laser-game/back/README.md

# Back
PCB includes battery monitoring, booster and indication.

placement
