laser-game/back/fab/back.pdf

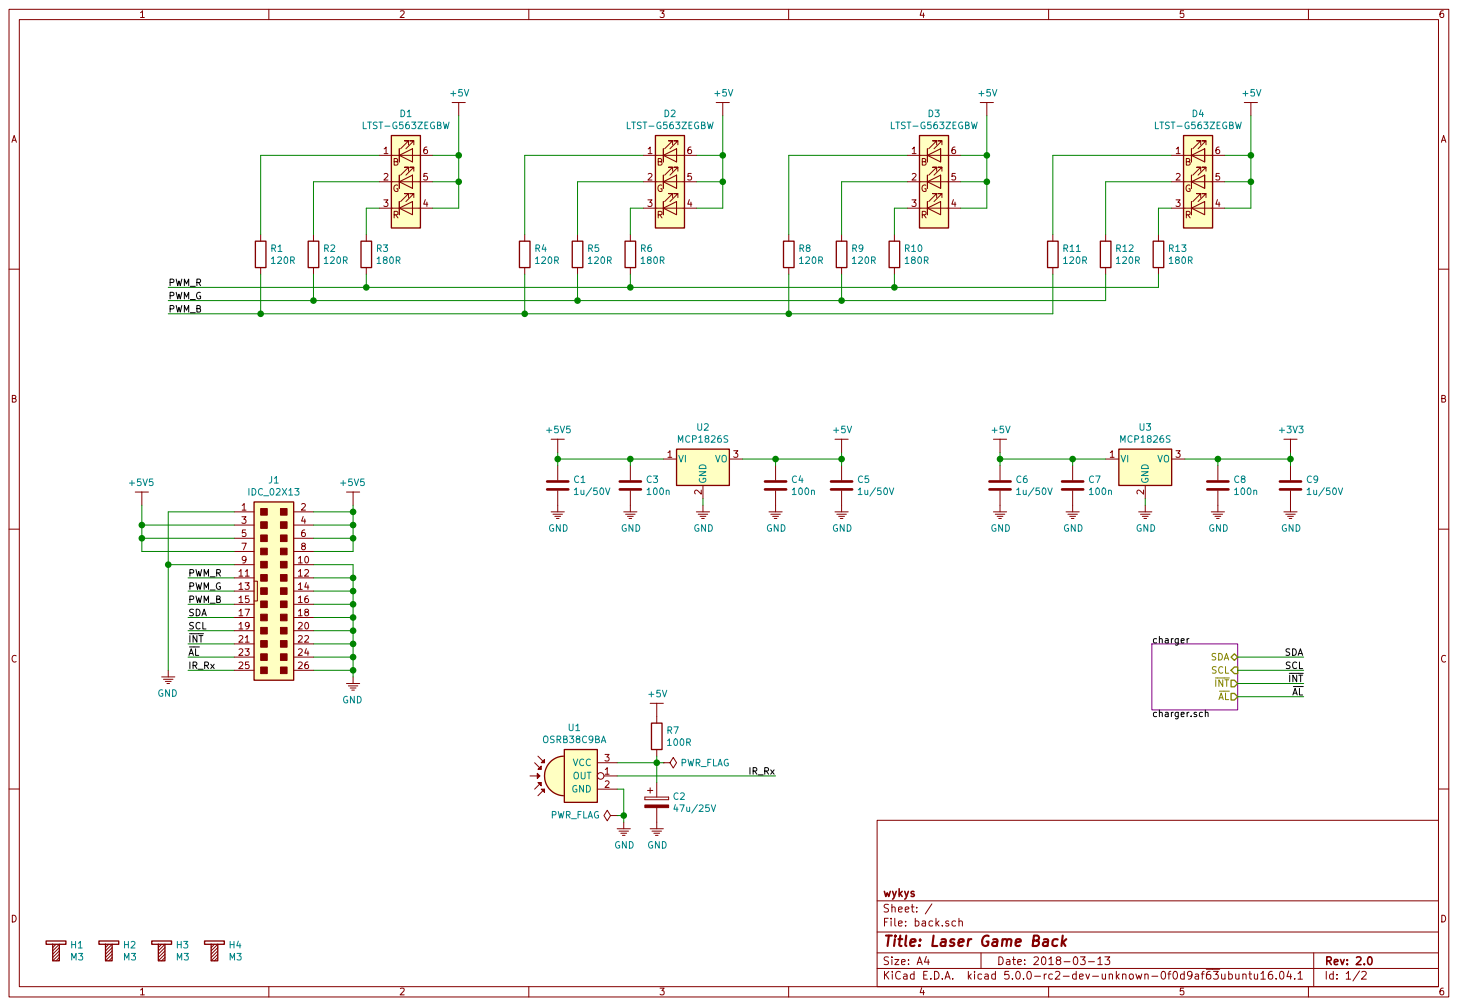
[picture p1: page 1]

File: back.sch Sheet: / wykys

Id: 1/2 Title: Laser Game Back

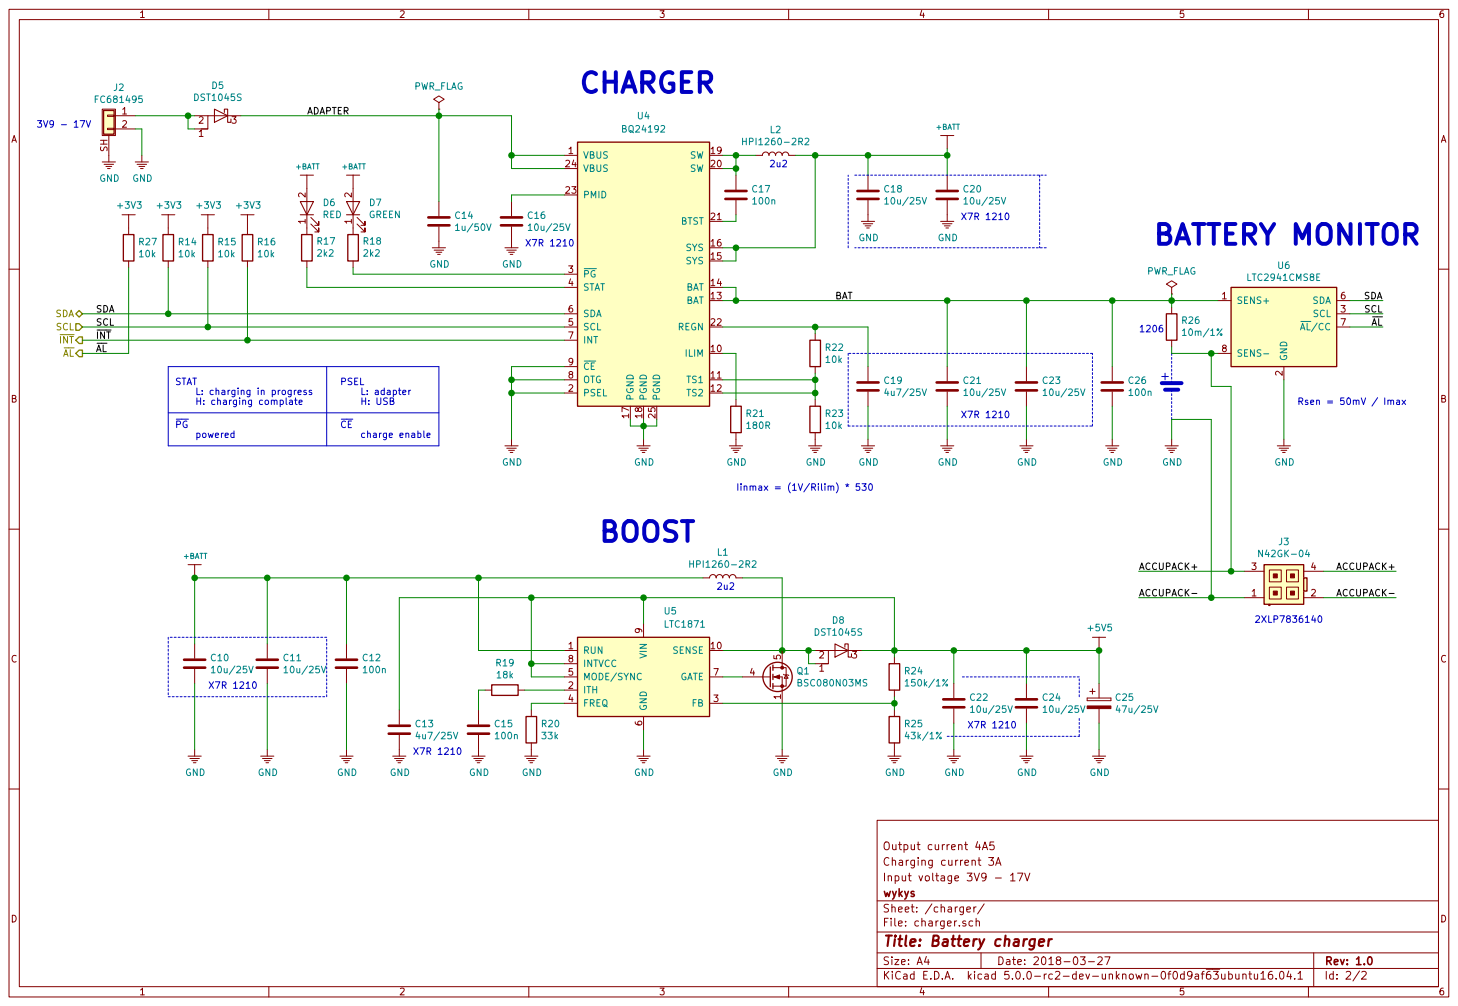
[picture p2: page 2]

2 SCL 3 SDA 6 AL/CC 7 SENS- 8 U6

L: charging in progress H: charging complate PG | charge enable PSEL L: adapter H: USB

Output current 4A5
Charging current 3A
Input voltage 3V9 - 17V
wykys
Sheet: /charger/
File: charger.sch
Id: 2/2 Title: Battery charger
