laser-game/back/sim/boost.asc

C1: cap; 47µ
C2: cap; 22µ
C3: cap; 4.7µ
C4: cap; 100n
C5: cap; 22µ
C6: cap; 100n
D1: schottky; MBRS360
L1: ind; 2.2µ
M1: nmos; BSC080N03MS
R1: res; 150k
R2: res; 43k
R3: res; 33k
R4: res; 18k
R5: res; 18
R6: res; 1.4
S1: sw
U1: LTC1871
V1: voltage; 2.7
V2: voltage; PULSE(-1 1 400u 0 0 200u 400u 1)
V3: voltage; 0
Named nets: 0, OUT, BAT
.tran 0 1m 0 1u startup uic
.model SW SW()
*.step param X 20k 30k 10k
