laser-game/back/hw/back.kicad_pcb

## KiCad design hw/back.kicad_pcb (2018-04-20)

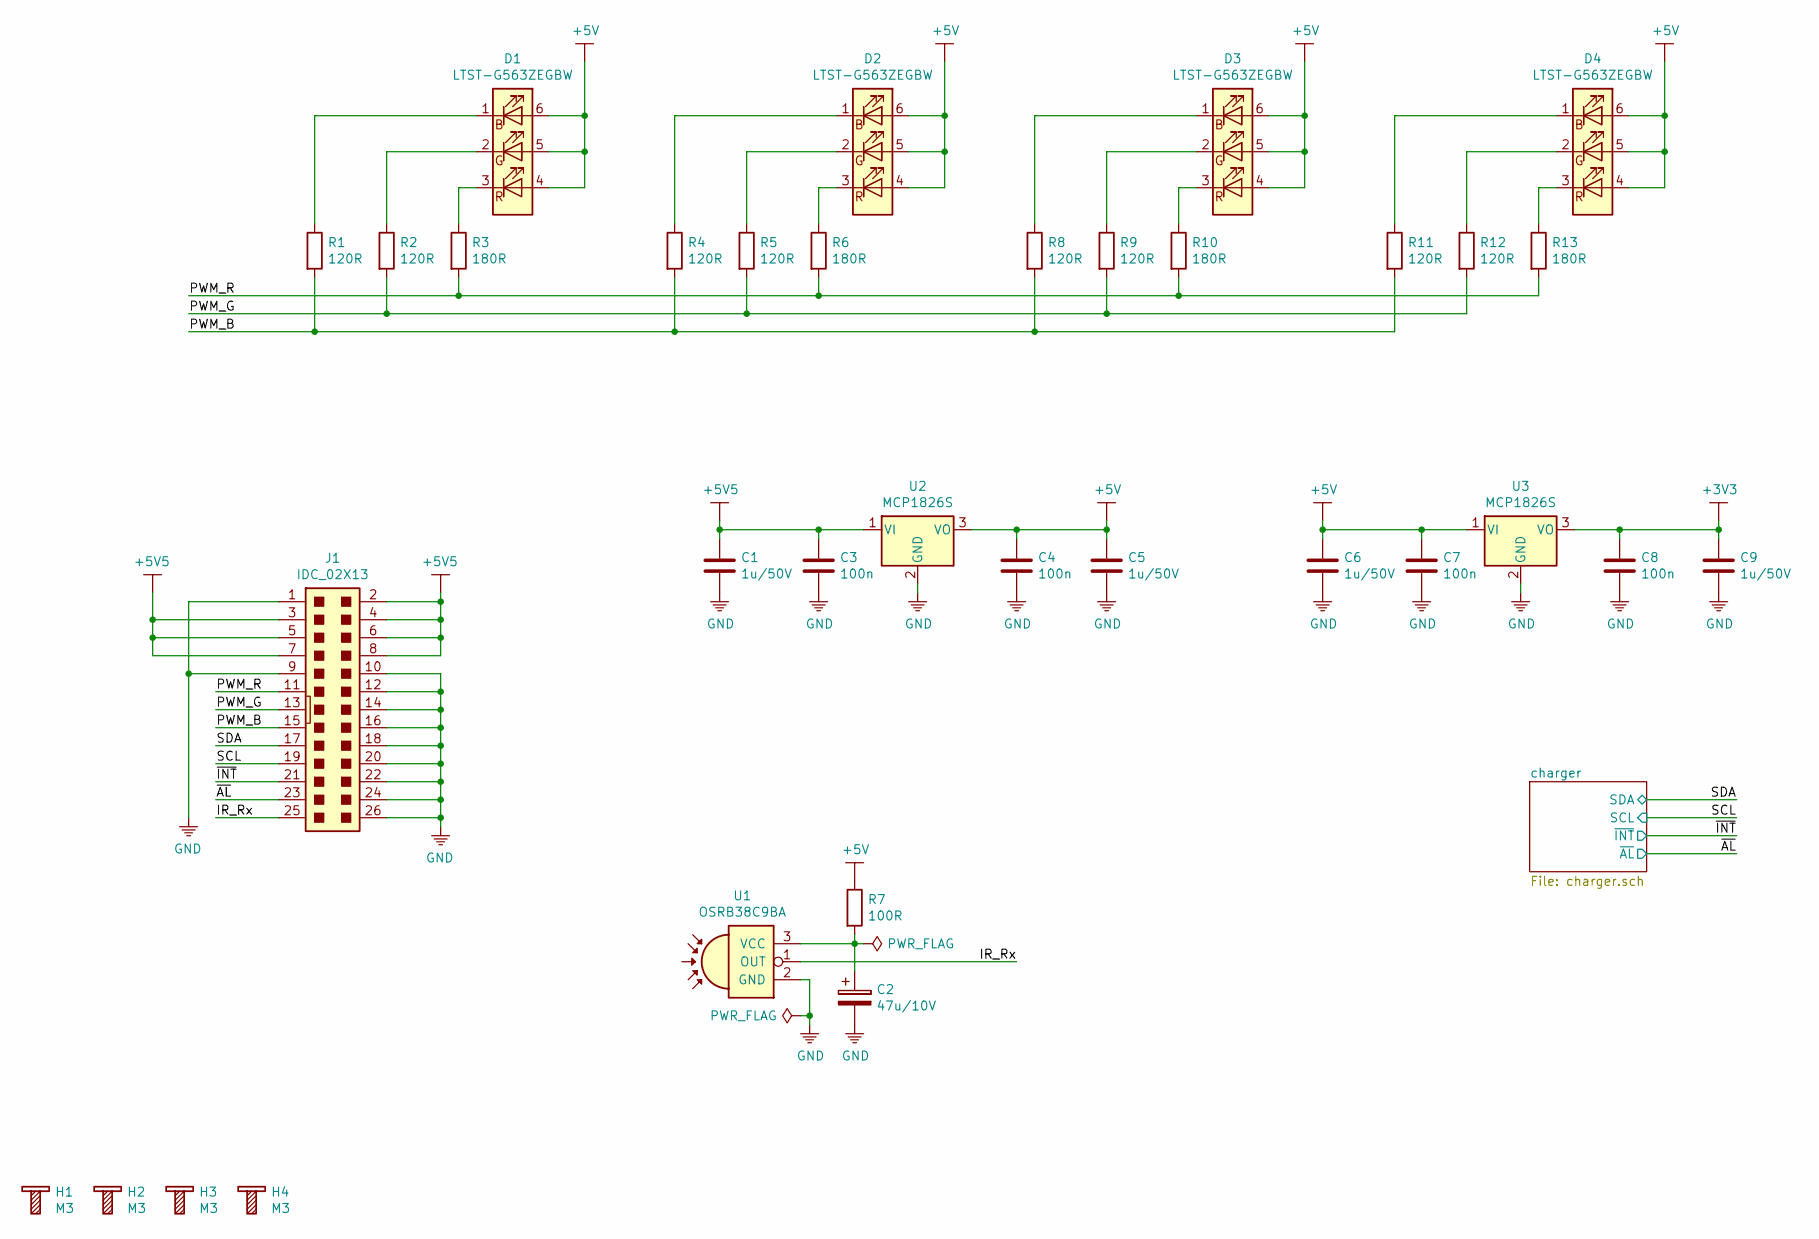
[picture p3: schematic back.sch, Laser Game Back]

Parts:
C1, C5, C6, C9: 1u/50V; C_0805_2012Metric
C2: 47u/10V; CP_EIA-3528-21_Kemet-B
C3, C4, C7, C8: 100n; C_0805_2012Metric
D1, D2, D3, D4: LTST-G563ZEGBW; LED_RGB_5050-6
H1, H2, H3, H4: M3; Bolt_M3
J1: IDC_02X13; IDC-Header_2x13_P2.54mm_Vertical
R1, R2, R4, R5, R8, R9, R11, R12: 120R; R_0805_2012Metric
R3, R6, R10, R13: 180R; R_0805_2012Metric
R7: 100R; R_0805_2012Metric
U1: OSRB38C9BA; OSRB8C9BA_Horizontal
U2, U3: MCP1826S; SOT-223-3_TabPin2

Connections:
+3V3: C8.1, C9.1, U3.3 (VO); also elsewhere on the board
+5V: C4.1, C5.1, C6.1, C7.1, D1.4 (BA), D1.5 (GA), D1.6 (RA), D2.4 (BA), D2.5 (GA), D2.6 (RA), D3.4 (BA), D3.5 (GA), D3.6 (RA), D4.4 (BA), D4.5 (GA), D4.6 (RA), R7.1, U2.3 (VO), U3.1 (VI)
+5V5: C1.1, C3.1, J1.2, J1.3, J1.4, J1.5, J1.6, J1.7, J1.8, U2.1 (VI); also elsewhere on the board
/IR_Rx: J1.25, U1.1 (OUT)
/PWM_B: J1.15, R1.2, R4.2, R8.2, R11.2
/PWM_G: J1.13, R2.2, R5.2, R9.2, R12.2
/PWM_R: J1.11, R3.2, R6.2, R10.2, R13.2
/SCL: J1.19; also elsewhere on the board
/SDA: J1.17; also elsewhere on the board
/~AL: J1.23; also elsewhere on the board
/~INT: J1.21; also elsewhere on the board
GND: C1.2, C2.2, C3.2, C4.2, C5.2, C6.2, C7.2, C8.2, C9.2, J1.1, J1.9, J1.10, J1.12, J1.14, J1.16, J1.18, J1.20, J1.22, J1.24, J1.26, U1.2 (GND), U2.2 (GND), U3.2 (GND); also elsewhere on the board
unnamed: C2.1, R7.2, U1.3 (VCC)
unnamed: D1.1 (RK), R1.1
unnamed: D1.2 (GK), R2.1
unnamed: D1.3 (BK), R3.1
unnamed: D2.1 (RK), R4.1
unnamed: D2.2 (GK), R5.1
unnamed: D2.3 (BK), R6.1
unnamed: D3.1 (RK), R8.1
unnamed: D3.2 (GK), R9.1
unnamed: D3.3 (BK), R10.1
unnamed: D4.1 (RK), R11.1
unnamed: D4.2 (GK), R12.1
unnamed: D4.3 (BK), R13.1

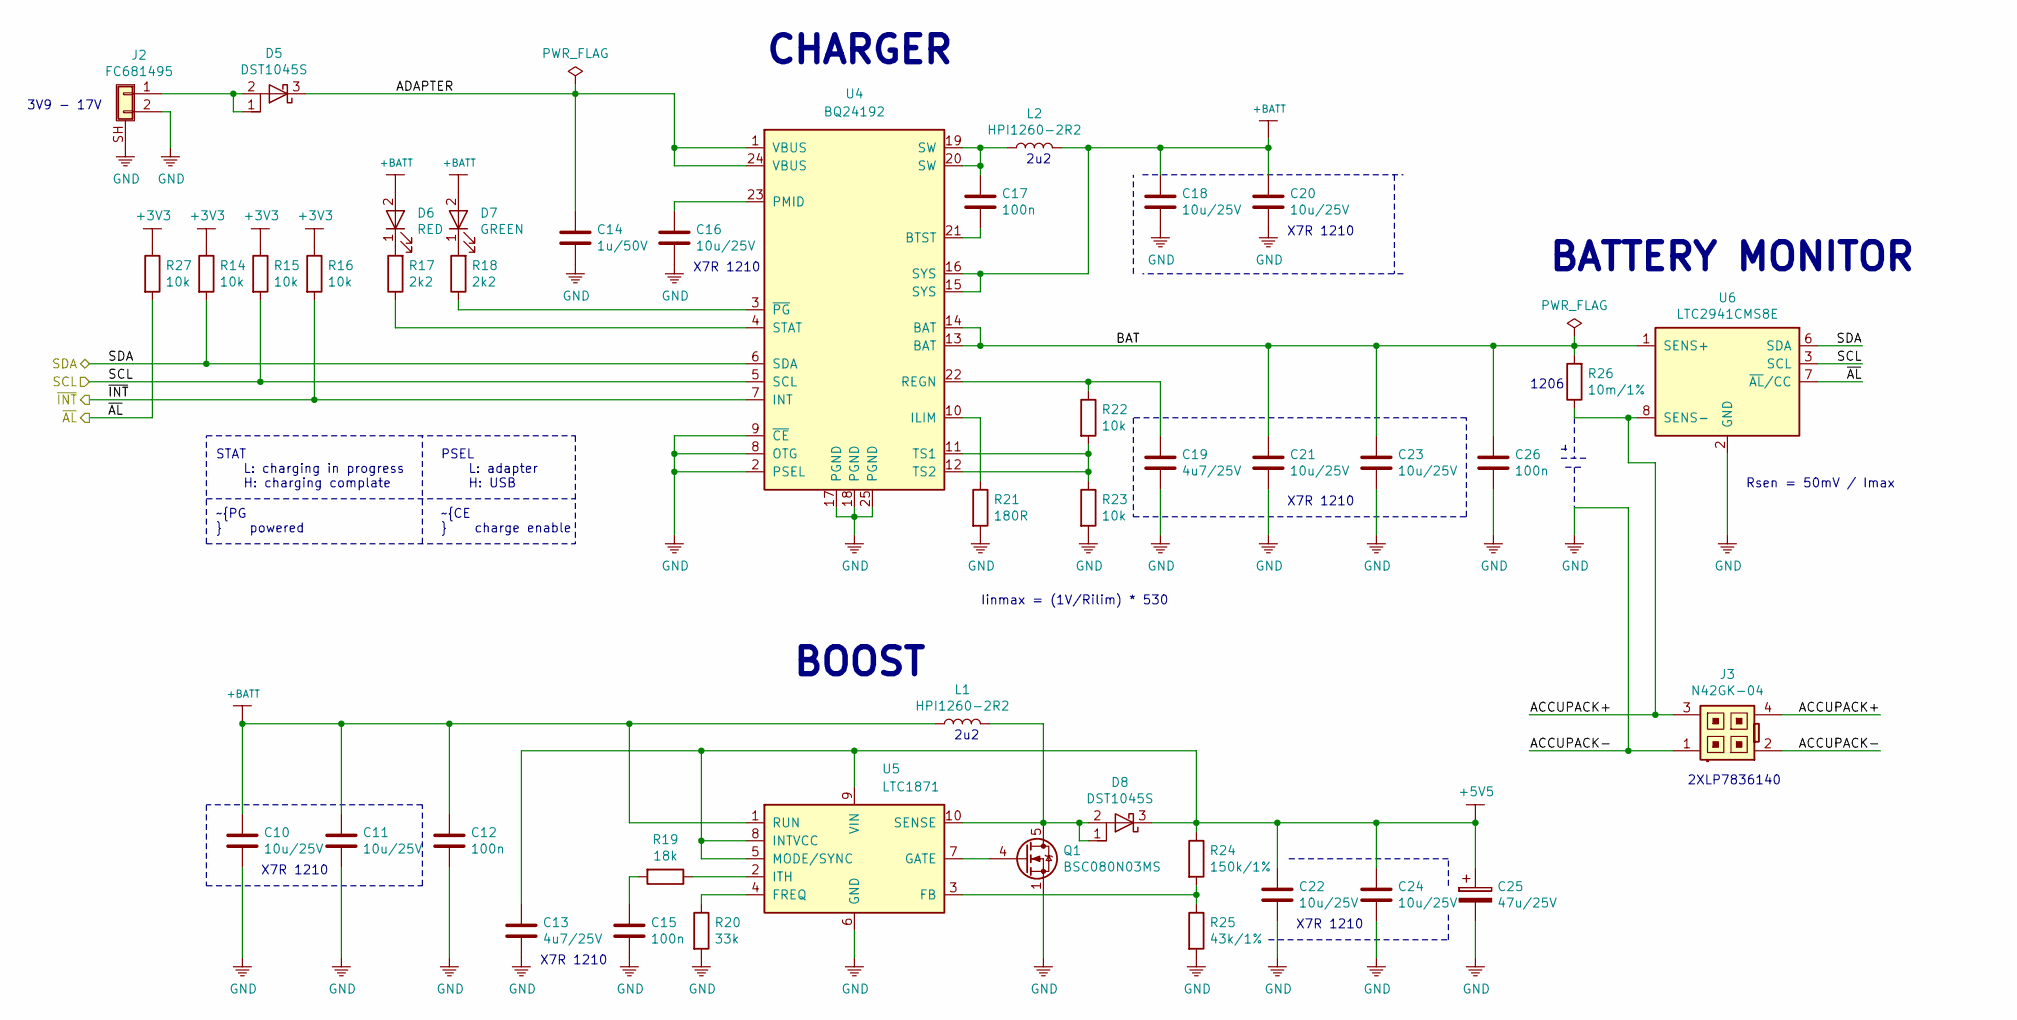
[picture p4: schematic charger.sch, Battery charger]

Parts:
C10, C11, C16, C18, C20, C21, C22, C23, C24: 10u/25V; C_1210_3225Metric
C12, C15, C17, C26: 100n; C_0805_2012Metric
C13, C19: 4u7/25V; C_1206_3216Metric
C14: 1u/50V; C_0805_2012Metric
C25: 47u/25V; CP_EIA-7343-31_Kemet-D
D5, D8: DST1045S; TO-277B
D6: RED; LED_0805_2012Metric
D7: GREEN; LED_0805_2012Metric
J2: FC681495; Cliff_FC681495
J3: N42GK-04
L1, L2: HPI1260-2R2; L_12x12mm_H4.5mm
Q1: BSC080N03MS; TDSON-8-1
R14, R15, R16, R22, R23, R27: 10k; R_0805_2012Metric
R17, R18: 2k2; R_0805_2012Metric
R19: 18k; R_0805_2012Metric
R20: 33k; R_0805_2012Metric
R21: 180R; R_0805_2012Metric
R24: 150k/1%; R_0805_2012Metric
R25: 43k/1%; R_0805_2012Metric
R26: 10m/1%; R_1206_3216Metric
U4: BQ24192; QFN-24-1EP_4x4mm_P0.5mm_EP2.6x2.6mm
U5: LTC1871; MSOP-10_3x3mm_P0.5mm
U6: LTC2941CMS8E; MSOP-8-1EP_3x3mm_P0.65mm_EP1.68x1.88mm

Connections:
+3V3: R14.1, R15.1, R16.1, R27.1; also elsewhere on the board
+5V5: C13.1, C22.1, C24.1, C25.1, D8.3 (K), R24.1, U5.5 (MODE/SYNC), U5.8 (INTVCC), U5.9 (VIN); also elsewhere on the board
+BATT: C10.1, C11.1, C12.1, C18.1, C20.1, D6.2 (A), D7.2 (A), L1.1, L2.2, U4.15 (SYS), U4.16 (SYS), U5.1 (RUN)
/SCL: R15.2, U4.5 (SCL), U6.3 (SCL); also elsewhere on the board
/SDA: R14.2, U4.6 (SDA), U6.6 (SDA); also elsewhere on the board
/charger/ACCUPACK+: J3.3, J3.4, R26.1, U6.8 (SENS-)
/charger/ADAPTER: C14.1, D5.3 (K), U4.1 (VBUS), U4.24 (VBUS)
/charger/BAT: C21.1, C23.1, C26.1, R26.2, U4.13 (BAT), U4.14 (BAT), U6.1 (SENS+)
/~AL: R27.2, U6.7 (~AL~/CC); also elsewhere on the board
/~INT: R16.2, U4.7 (INT); also elsewhere on the board
GND: C10.2, C11.2, C12.2, C13.2, C14.2, C15.2, C16.2, C18.2, C19.2, C20.2, C21.2, C22.2, C23.2, C24.2, C25.2, C26.2, J2.2, J2.SH (Shield), J3.1, J3.2, Q1.1 (S), Q1.2 (S), Q1.3 (S), R20.2, R21.2, R23.2, R25.2, U4.2 (PSEL), U4.8 (OTG), U4.9 (~CE), U4.17 (PGND), U4.18 (PGND), U4.25 (PGND), U5.6 (GND), U6.2 (GND); also elsewhere on the board
unnamed: C15.1, R19.2
unnamed: C16.1, U4.23 (PMID)
unnamed: C17.1, L2.1, U4.19 (SW), U4.20 (SW)
unnamed: C17.2, U4.21 (BTST)
unnamed: C19.1, R22.1, U4.22 (REGN)
unnamed: D5.1 (A), D5.2 (A), J2.1
unnamed: D6.1 (K), R17.2
unnamed: D7.1 (K), R18.2
unnamed: D8.1 (A), D8.2 (A), L1.2, Q1.5 (D), U5.10 (SENSE)
unnamed: Q1.4 (G), U5.7 (GATE)
unnamed: R17.1, U4.4 (STAT)
unnamed: R18.1, U4.3 (~PG)
unnamed: R19.1, U5.2 (ITH)
unnamed: R20.1, U5.4 (FREQ)
unnamed: R21.1, U4.10 (ILIM)
unnamed: R22.2, R23.1, U4.11 (TS1), U4.12 (TS2)
unnamed: R24.2, R25.1, U5.3 (FB)

Notes on the sheet:
~CE charge enable
PSEL L: adapter H: USB
X7R 1210
CHARGER
BATTERY MONITOR
BOOST
2u2
Rsen = 50mV / Imax
Iinmax = (1V/Rilim) * 530
STAT L: charging in progress H: charging complate
~PG powered
3V9 - 17V
1206
2XLP7836140

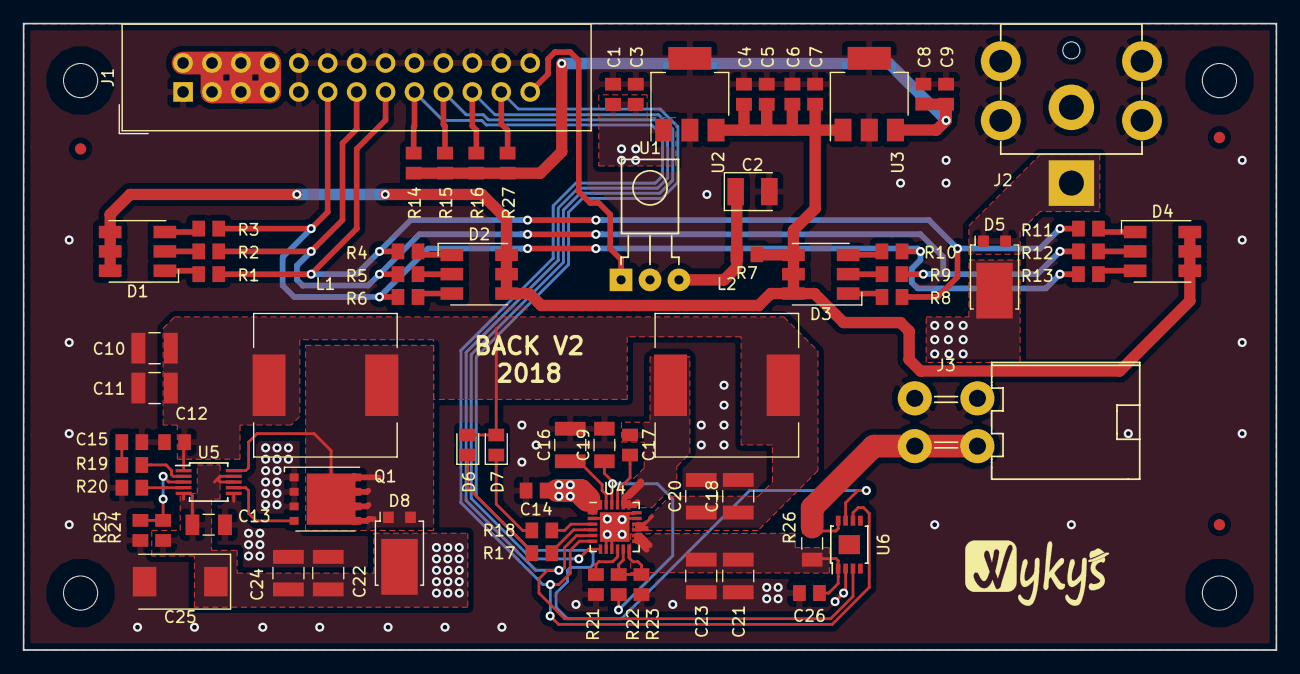
[picture p5: board back.kicad_pcb from above]

Board: 2 copper layers, 110.0 x 55.0 mm, 77 parts (0 on the bottom side), 46 nets.
