laser-game/back/(commit log)

2018-03-13 created kicad project
    [back.kicad_pcb, back.sch]
2018-03-21 added first schematic protitype
    [back.sch]
2018-03-26 updated schematic, select components
    [back.sch]
2018-03-27 updated schematic, completed charger and created hierarchial list for charger
    [back.sch, charger.sch]
2018-03-27 moved files
    [back.kicad_pcb, back.sch, charger.sch]
2018-03-28 updated schematic ERC ok
    [back.sch, charger.sch]
2018-03-28 updated schematic
    [charger.sch]
2018-04-17 updated pcb
    [back.kicad_pcb]
2018-04-20 updated C2 footprint
    [back.kicad_pcb, back.sch]
2018-04-20 updated power connector footprint
    [back.kicad_pcb]
2018-04-20 chenged pads from thermal to solid in boost
    [back.kicad_pcb]
2018-05-02 added boom file and schematic for fabracation
    [back.csv]
