laser-game/back/(notices)

Notices in the files:
README.md:
License: CC BY-NC-ND 4.0
